rtek1000/ATtiny85_DS18B20_Thermostat/Hardware/Readme.md

Pinout image:

Source: https://mjvo.github.io/tutorials/circuits/attiny85/
