rtek1000/ATtiny85_DS18B20_Thermostat/Hardware/attiny85pinout.png

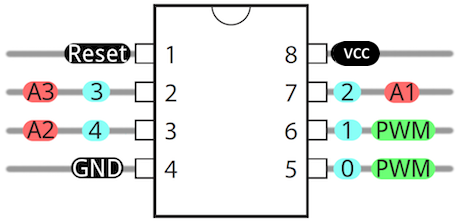
Hardware/attiny85pinout.png
