rtek1000/ATtiny85_DS18B20_Thermostat/Hardware/DS18B20 2213C4.png

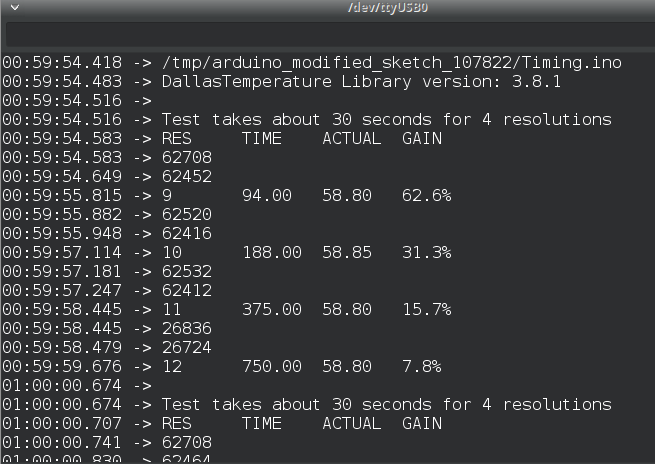
Hardware/DS18B20 2213C4.png
