rtek1000/ATtiny85_DS18B20_Thermostat/Software/Attiny85_DS18B20_thermostat_v2.ino

// Source: https://github.com/rtek1000/Attiny85_DS18B20_thermostat

// Attiny85 pinout - Prog. ref num. - Prog. ref. name:
// 1 - RESET -
// 2 - 3/A3 - ONE_WIRE_PRW
// 3 - 4/A2 - ONE_WIRE_BUS
// 4 - GND
// 5 - 0/PWM - LED_INFO_OUT
// 6 - 1/PWM - LED_TH_OUT
// 7 - 2/A1 - LED_ERROR
// 8 - VDD

// Include the libraries we need
#include <OneWire.h>
#include <DallasTemperature.h>
#include <avr/wdt.h>

#define ONE_WIRE_PRW 3
#define ONE_WIRE_BUS 4

#define BEEP 2
#define LED_INFO_OUT 0
#define LED_TH_OUT 1

#define temp_max_setpoint 110.0
#define temp_min_setpoint 70.0
#define temp_max_all_sensors 55.0

#define TEMPERATURE_PRECISION 9 // Lower resolution

#define average_index 5

// Setup a oneWire instance to communicate with any OneWire devices (not just Maxim/Dallas temperature ICs)
OneWire oneWire(ONE_WIRE_BUS);

// Pass our oneWire reference to Dallas Temperature.
DallasTemperature sensors(&oneWire);

DeviceAddress tempDeviceAddress0; // We'll use this variable to store a found device address
DeviceAddress tempDeviceAddress1; // We'll use this variable to store a found device address

int start_info = 0;

float tempC0 = 0.0;
float tempC1 = 0.0;

int error_cnt = 0;

int info_cycle_cnt = 0;

int cycle_cnt = 0;

int temp_show_channel = 0;

float tempC_buff = 0.0;

float tempC_buff2 = 0.0;

int temp100 = 0;
int temp10 = 0;
int temp1 = 0;

bool invert = false;

bool is_negative = false;

unsigned int phase_cnt = 0;
unsigned int phase_cnt2 = 0;

bool sensor_error = false;

/*
   The setup function. We only start the sensors here
*/
void setup(void)
{
  wdt_disable();

  cli();
  WDTCR = 0xD8 | WDTO_2S;
  sei();

  wdt_reset();

  pinMode(LED_TH_OUT, OUTPUT);
  pinMode(LED_INFO_OUT, OUTPUT);
  pinMode(ONE_WIRE_PRW, OUTPUT);
  pinMode(BEEP, OUTPUT);

  digitalWrite(BEEP, LOW);
  digitalWrite(ONE_WIRE_PRW, HIGH);

  digitalWrite(LED_TH_OUT, LOW);

  for (int i = 0; i < 10; i++) {
    delay(100);

    wdt_reset();
  }

  sensors_begin();

  tempC_buff2 = temp_max_setpoint;
}

/*
   Main function, get and show the temperature
*/
void loop(void)
{
  float tempCtmp0;
  float tempCtmp1;
  float tempCtmp0Sum;
  float tempCtmp1Sum;

  tempCtmp0Sum = 0;
  tempCtmp1Sum = 0;

  for (int i = 0; i < average_index; i++) {
    sensors.requestTemperatures(); // Send the command to get temperatures

    tempCtmp0 = sensors.getTempC(tempDeviceAddress0);
    tempCtmp1 = sensors.getTempC(tempDeviceAddress1);

    if (sensor_error) {
      tempCtmp1 = 0.0;
    }

    // Check if reading was successful
    if ((tempCtmp0 != DEVICE_DISCONNECTED_C) && (tempCtmp1 != DEVICE_DISCONNECTED_C))
    {
      tempCtmp0Sum += tempCtmp0;
      tempCtmp1Sum += tempCtmp1;
    }
    else
    {
      break;
    }

    if (info_cycle_cnt == 0) {
      if (LED_info(tempC_buff2) != 0) {
        info_cycle_cnt = 35;

        phase_cnt = 0;

        if (start_info == 0) {
          tempC_buff2 = temp_min_setpoint;

          start_info++;
        } else if (start_info == 1) {
          tempC_buff2 = temp_max_all_sensors;

          start_info++;
        } else {
          tempC_buff2 = tempC_buff;

          if (temp_show_channel < 1) {
            temp_show_channel++;
          } else {
            temp_show_channel = 0;
          }
        }
      }
    } else {
      info_cycle_cnt--;
    }

    wdt_reset();
  }

  if ((tempCtmp0 != DEVICE_DISCONNECTED_C) && (tempCtmp1 != DEVICE_DISCONNECTED_C) && (sensor_error != true)) {
    tempC0 = tempCtmp0Sum / average_index;
    tempC1 = tempCtmp1Sum / average_index;

    if (((tempC0 > temp_max_setpoint) || (tempC1 > temp_max_setpoint)) || ((tempC0 > temp_max_all_sensors) && (tempC1 > temp_max_all_sensors))) {
      digitalWrite(LED_TH_OUT, HIGH);
    } else if (((tempC0 < temp_min_setpoint) && (tempC1 < temp_min_setpoint)) && ((tempC0 < temp_max_all_sensors) && (tempC1 < temp_max_all_sensors))) {
      digitalWrite(LED_TH_OUT, LOW);
    }

    if (temp_show_channel == 0) {
      tempC_buff = tempC0;
    } else if (temp_show_channel == 1) {
      tempC_buff = tempC1;
    }

    error_cnt = 0;
  } else {
    if (error_cnt < 5) {
      error_cnt++;
    } else {
      digitalWrite(LED_TH_OUT, HIGH);
    }

    digitalWrite(ONE_WIRE_PRW, LOW);

    for (int i = 0; i < 10; i++) {
      if (digitalRead(LED_TH_OUT) == HIGH) {
        analogWrite(LED_INFO_OUT, 250 - (i * 25));
      } else {
        analogWrite(LED_INFO_OUT, 100 - (i * 5));
      }
      delay(100);

      wdt_reset();
    }

    digitalWrite(ONE_WIRE_PRW, HIGH);

    for (int i = 0; i < 10; i++) {
      if (digitalRead(LED_TH_OUT) == HIGH) {
        analogWrite(LED_INFO_OUT, i * 25);
      } else {
        analogWrite(LED_INFO_OUT, i * 5);
      }

      delay(100);

      wdt_reset();
    }

    sensors_begin();
  }

  if (digitalRead(LED_TH_OUT) == HIGH) {
    digitalWrite(BEEP, !digitalRead(BEEP));
  }
}

void sensors_begin(void) {
  sensors.begin();

  sensors.getAddress(tempDeviceAddress0, 0);

  wdt_reset();
  
  sensors.getAddress(tempDeviceAddress1, 1);

  wdt_reset();

  uint8_t j = 0;

  for (uint8_t i = 0; i < 8; i++) {
    if (tempDeviceAddress0[i] == tempDeviceAddress1[i]) {
      j++;
    }
  }

  if (j == 8) {
    sensor_error = true;
  } else {
    sensor_error = false;
  }

  if (sensors.getResolution(tempDeviceAddress0) != TEMPERATURE_PRECISION) {
    sensors.setResolution(tempDeviceAddress0, TEMPERATURE_PRECISION);
  }

  wdt_reset();

  if (sensors.getResolution(tempDeviceAddress1) != TEMPERATURE_PRECISION) {
    sensors.setResolution(tempDeviceAddress1, TEMPERATURE_PRECISION);
  }

  wdt_reset();
}

int LED_info(int temp) {
  if (phase_cnt == 0) {
    if (temp < 0) {
      temp *= -1;

      is_negative = true;
    }

    invert = digitalRead(LED_TH_OUT);

    temp100 = temp / 100;
    temp10 = (temp - (temp100 * 100)) / 10;
    temp1 = temp - (temp100 * 100) - (temp10 * 10);

    phase_cnt2 = 0;

    if (is_negative == false) {
      if ((temp100 == 0) && (temp10 == 0)) {
        phase_cnt = 6;
      } else if (temp100 == 0) {
        phase_cnt = 4;
      } else {
        phase_cnt = 2;
      }
    } else {
      phase_cnt++;
    }
  } else if (phase_cnt == 1) {
    if (is_negative == true) {
      if (phase_cnt2 == 0) {
        if (invert == true) {
          analogWrite(LED_INFO_OUT, 128);
        } else {
          analogWrite(LED_INFO_OUT, 64);
        }
      } if (phase_cnt2 == 8) {
        if (invert == true) {
          analogWrite(LED_INFO_OUT, 16);
        } else {
          digitalWrite(LED_INFO_OUT, LOW);
        }
      } if (phase_cnt2 == 11) {
        wdt_reset();

        if ((temp100 == 0) && (temp10 == 0)) {
          phase_cnt = 6;
        } else if (temp100 == 0) {
          phase_cnt = 4;
        } else {
          phase_cnt++;
        }
      }

      if (phase_cnt2 < 11) {
        phase_cnt2++;
      } else {
        phase_cnt2 = 0;
      }
    } else {
      phase_cnt++;
    }
  } else if (phase_cnt == 2) {
    if (temp100 > 0) {
      LED_info_phases(temp100);
    } else {
      phase_cnt = 4; // skip delay

      phase_cnt2 = 0;
    }
  } else if (phase_cnt == 3) {
    if (phase_cnt2 == 0) {
      wdt_reset();
    } else if (phase_cnt2 == 7) {
      wdt_reset();

      phase_cnt++;
    }

    if (phase_cnt2 < 7) {
      phase_cnt2++;
    } else {
      phase_cnt2 = 0;
    }
  } else if (phase_cnt == 4) {
    if ((temp100 > 0) || (temp10 > 0)) {
      LED_info_phases(temp10);
    } else {
      phase_cnt = 6; // skip delay

      phase_cnt2 = 0;
    }
  } else if (phase_cnt == 5) {
    if (phase_cnt2 == 0) {
      wdt_reset();
    } else if (phase_cnt2 == 7) {
      wdt_reset();

      phase_cnt++;
    }

    if (phase_cnt2 < 7) {
      phase_cnt2++;
    } else {
      phase_cnt2 = 0;
    }
  } else if (phase_cnt == 6) {
    LED_info_phases(temp1);
  } else if (phase_cnt == 7) {
    if (phase_cnt2 == 0) {
      wdt_reset();
    } else if (phase_cnt2 == 7) {
      wdt_reset();

      return 1;
    }

    if (phase_cnt2 < 7) {
      phase_cnt2++;
    }
  }

  return 0;
}

void LED_info_phases(int& temp_var) {
  if (phase_cnt2 == 0) {
    if (invert == true) {
      analogWrite(LED_INFO_OUT, 96);
    } else {
      analogWrite(LED_INFO_OUT, 48);
    }
  } if ((phase_cnt2 == 1) || (phase_cnt2 == 4)) {
    if (((phase_cnt2 == 1) && (temp_var > 0)) || ((phase_cnt2 == 4) && (temp_var == 0))) {
      if (invert == true) {
        analogWrite(LED_INFO_OUT, 16);
      } else {
        digitalWrite(LED_INFO_OUT, LOW);
      }
    }
  } if (phase_cnt2 == 5) {
    wdt_reset();

    if (temp_var > 1) {
      temp_var--;
    } else {
      phase_cnt++;
    }
  }

  if (phase_cnt2 < 5) {
    phase_cnt2++;

    wdt_reset();
  } else {
    phase_cnt2 = 0;
  }
}
