rtek1000/ATtiny85_DS18B20_Thermostat/(commit log)

2020-10-30 Add files via upload
    Schematic diagram of the electronic circuit of the hardware. Thermostat with DS18B20 temperature sensor and Attiny85 microcontroller.
2020-10-30 Add files via upload
    Arduino IDE settings
